ubicompteam/k-sensor/atmospheric environmental measuring instrument/README.md

## APM v1 
- 동작 방식



<br><br>

## APM v2
- 동작 방식



## APM v2.1
- 동작 방식
