ubicompteam/k-sensor/atmospheric environmental measuring instrument/GoPM/src/Mobius_server_mqtt/README.md

# Mobius Server MQTT

## Language Selection

[English](README.md) | [한국어](README_KR.md)

<br><br>

## File Descriptions
- **thyme**: Handles essential functions for managing IoT data by configuring various communication protocols, storing data in files, and processing it based on specified paths. It facilitates communication with the Mobius platform.
- **tas**: Reads configuration values from `conf.xml` and transmits or receives data based on TAS status in the IoT system. Also manages control signals within the IoT system.

<br><br>

**In-depth code interpretation is available within each file.**
