ubicompteam/k-sensor/atmospheric environmental measuring instrument/APM_v1/src/Motor_control/README.md

# 설명

### RX
- 미세먼지 값이랑 TX에서 들어오는 모터 값을 합쳐서 jetson nano로 serial 통신

### TX
- 상단 모터 3개, 하단 모터 1개(3개)를 사용자 입력으로 제어
- 제어된 값의 위치를 uart통신으로 미세먼지 값 측정하는 보드로 전송

### 2_auto
- 2시간 간격으로 모터 각각의 위치를 옮기는 자동화 코드

<br>

### 헤더파일, cpp 파일은 변경이 되었으니 이전꺼 말고 이것을 다운 받아 쓰세요

---

#### 모터 위치 값은 계속 저장되어 있으므로
