ubicompteam/k-sensor/atmospheric environmental measuring instrument/APM_v2/src/DAQ/README.md

# 코드 설명

## DAQ
- 레퍼런스 장비의 시간을 기준으로 제작한 APM2의 데이터를 수집

## DAQ_V2
- 제작한 APM2 자체에서 1분마다 데이터를 수집
