ubicompteam/k-sensor/atmospheric environmental measuring instrument/APM_v2.1/Testing_V1/README.md

## 수정사힝
- 전체적인 코드 수정

## 에러 남
- 처음부터 다시 코드를 수정
