ubicompteam/k-sensor/atmospheric environmental measuring instrument/APM_v2.1/Testing_V1/slave/slave_1/slave_1.ino

#include <PMS.h>
#include <Wire.h>

#define SLAVE_ADDRESS 0x57

// Register addresses
#define WRITE_REGISTER 0x01
#define READ_REGISTER 0x02
#define START_SIGNAL 0xA0
#define GET_FEEDBACK 0xA1

char con_data[64];

const uint8_t pwmPins[] = {8, 9, 10};
const uint8_t tachPins[] = {2, 3, 4};
const uint8_t fanCount = 3;

volatile int tachCounters[fanCount] = {0, 0, 0};
unsigned long previousMillis = 0;
const long interval = 1000;

int targetRPMs[fanCount] = {900, 900, 900};
int currentPWMs[fanCount] = {30, 30, 30};
bool targetReached[fanCount] = {true, true, true};

const int minPWM = 30;

PMS pms1(Serial1);
PMS::DATA data1;

PMS pms2(Serial2);
PMS::DATA data2;

PMS pms3(Serial3);
PMS::DATA data3;

bool startReceived = false;
bool getFeedback = false;

uint8_t d1, d2, d3;
char real_RPM[fanCount][64];
uint8_t save_f = 0;

void setup() {
  Wire.begin(SLAVE_ADDRESS);
  Wire.onRequest(requestEvent);
  Wire.onReceive(receiveEvent);

  delay(100);
  
  for (int i = 0; i < fanCount; i++) {
    pinMode(tachPins[i], INPUT_PULLUP);
    pinMode(pwmPins[i], OUTPUT);
    analogWrite(pwmPins[i], minPWM);
  }

  attachInterrupt(digitalPinToInterrupt(tachPins[0]), tachCounterISR0, FALLING);
  attachInterrupt(digitalPinToInterrupt(tachPins[1]), tachCounterISR1, FALLING);
  attachInterrupt(digitalPinToInterrupt(tachPins[2]), tachCounterISR2, FALLING);
  
  Serial.begin(9600);
  Serial1.begin(9600);
  Serial2.begin(9600);
  Serial3.begin(9600);

  delay(100);

  pms1.passiveMode();
  pms2.passiveMode();
  pms3.passiveMode();
}

void loop() {
  unsigned long currentMillis = millis();
  if (currentMillis - previousMillis >= interval) {
    previousMillis = currentMillis;

    for (int i = 0; i < fanCount; i++) {
      int realRPM = (tachCounters[i] * 60) / 2;
      tachCounters[i] = 0;

      int error = targetRPMs[i] - realRPM;
      int pwmStep = 0;

      if (abs(error) > 1000) {
        pwmStep = 20;
      } else if (abs(error) > 450) {
        pwmStep = 10;
      } else if (abs(error) > 200) {
        pwmStep = 5;
      } else if (abs(error) > 30) {
        pwmStep = 1;
      }

      if (pwmStep > 0) {
        currentPWMs[i] += (error > 0) ? pwmStep : -pwmStep;
        currentPWMs[i] = constrain(currentPWMs[i], minPWM, 255);
        analogWrite(pwmPins[i], currentPWMs[i]);
      }

      if (abs(error) <= 100 && !targetReached[i]) {
        snprintf(real_RPM[i], sizeof(real_RPM[i]), "M1_P%d_%d", i + 1, realRPM);
        targetReached[i] = true;
      }
    }
  }
}

void receiveEvent(int howMany) {
    int registerAddress = Wire.read();
    
    if (registerAddress == WRITE_REGISTER) {
        char buffer[32];
        int index = 0;

        while (Wire.available() > 0 && index < sizeof(buffer) - 1) { 
            buffer[index++] = Wire.read();
        }
        buffer[index] = '\0';

        String receivedString = String(buffer);
        Serial.print("received: ");
        Serial.println(receivedString);

        int fanIndex = receivedString.substring(4, 5).toInt() - 1;
        int fanSpeed = receivedString.substring(6).toInt();
        if (fanIndex >= 0 && fanIndex < fanCount) {
            targetRPMs[fanIndex] = fanSpeed;
            save_f = fanIndex;
            targetReached[fanIndex] = false;
        }
    }
    else if (registerAddress == READ_REGISTER && Wire.available() > 0) {
        int signal = Wire.read();
        if (signal == START_SIGNAL) {
            startReceived = true;
        } else if (signal == GET_FEEDBACK) {
            getFeedback = true;
        }
    }
}

void requestEvent() {
    // I2C 통신 사이에 200ms 간격을 두어 안정성을 높임
    static unsigned long lastRequestTime = 0;  // 마지막 요청 시간 저장 변수
    unsigned long currentMillis = millis();    // 현재 시간 가져오기

    if (currentMillis - lastRequestTime > 10) { // 200ms 간격으로 I2C 데이터 요청
        lastRequestTime = currentMillis;  // 마지막 요청 시간 갱신

        if (startReceived) {
            startReceived = false;

            // PMS 센서에서 데이터를 요청
            pms1.requestRead();
            pms2.requestRead();
            pms3.requestRead();

            if (pms1.readUntil(data1)) {
                d1 = data1.PM_AE_UG_2_5;
            }

            if (pms2.readUntil(data2)) {
                d2 = data2.PM_AE_UG_2_5;
            }

            if (pms3.readUntil(data3)) {
                d3 = data3.PM_AE_UG_2_5;
            }

            snprintf(con_data, sizeof(con_data), "%d,%d,%d,%d,%d,%d", targetRPMs[0], targetRPMs[1], targetRPMs[2], d1, d2, d3);
            
            Wire.write((uint8_t*)con_data, strlen(con_data) + 1);
            Serial.println(con_data);
        }

        else if (getFeedback) {
            // I2C로 실제 RPM을 피드백으로 전송
            Wire.write((uint8_t*)real_RPM[save_f], strlen(real_RPM[save_f]) + 1);
            Serial.println(real_RPM[save_f]);
        }
    }
}

// ISR: 팬의 tach 센서를 통해 RPM 카운트를 증가시킴
void tachCounterISR0() {
  tachCounters[0]++;
}

void tachCounterISR1() {
  tachCounters[1]++;
}

void tachCounterISR2() {
  tachCounters[2]++;
}
